Hephaestus-Arm/Hephaestus-Brain/README.md

# Hephaestus-Brain
Samd 51 M4 based robot controller

# Breadboard and OTS variant



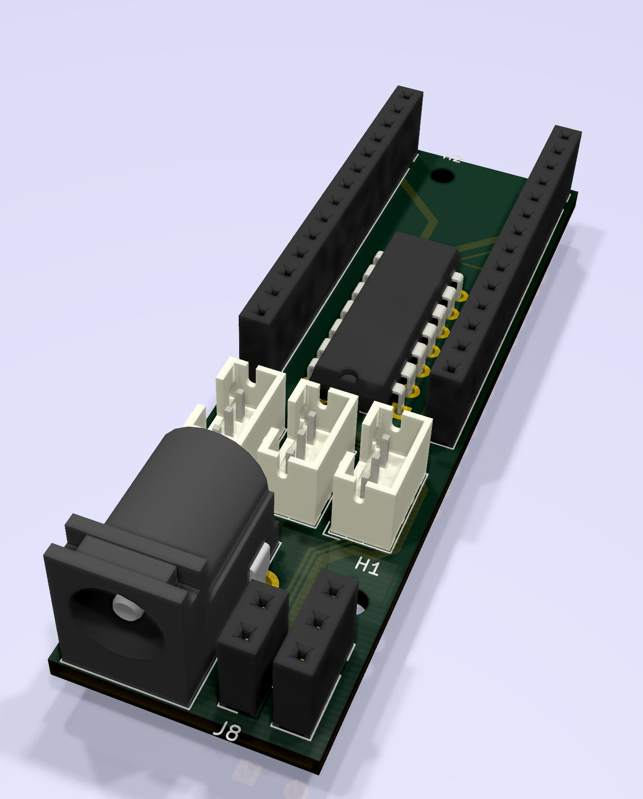
[picture p1: board.png]
Image of PCB
