Hephaestus-Arm/Hephaestus-Brain/pcb.png

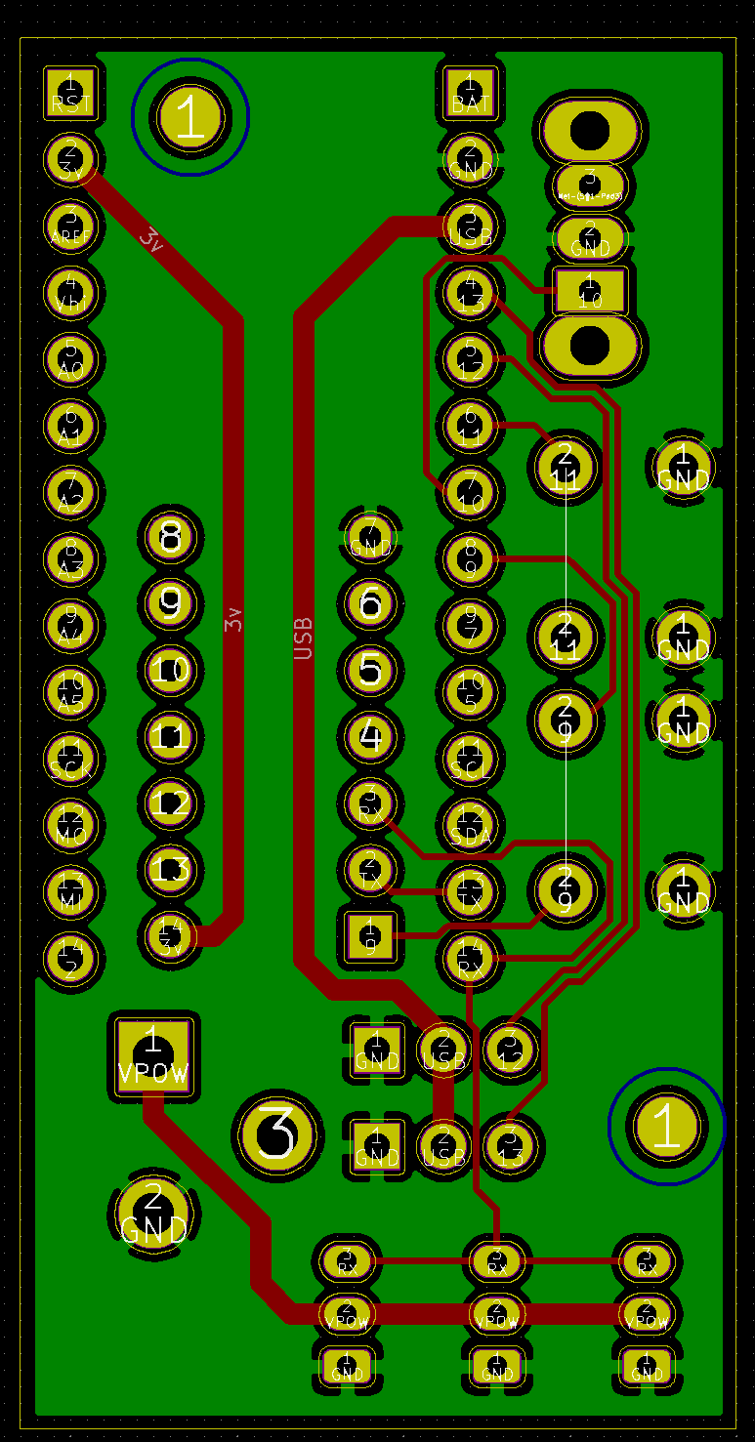
pcb.png
