Hephaestus-Arm/Hephaestus-Brain/schematic.png

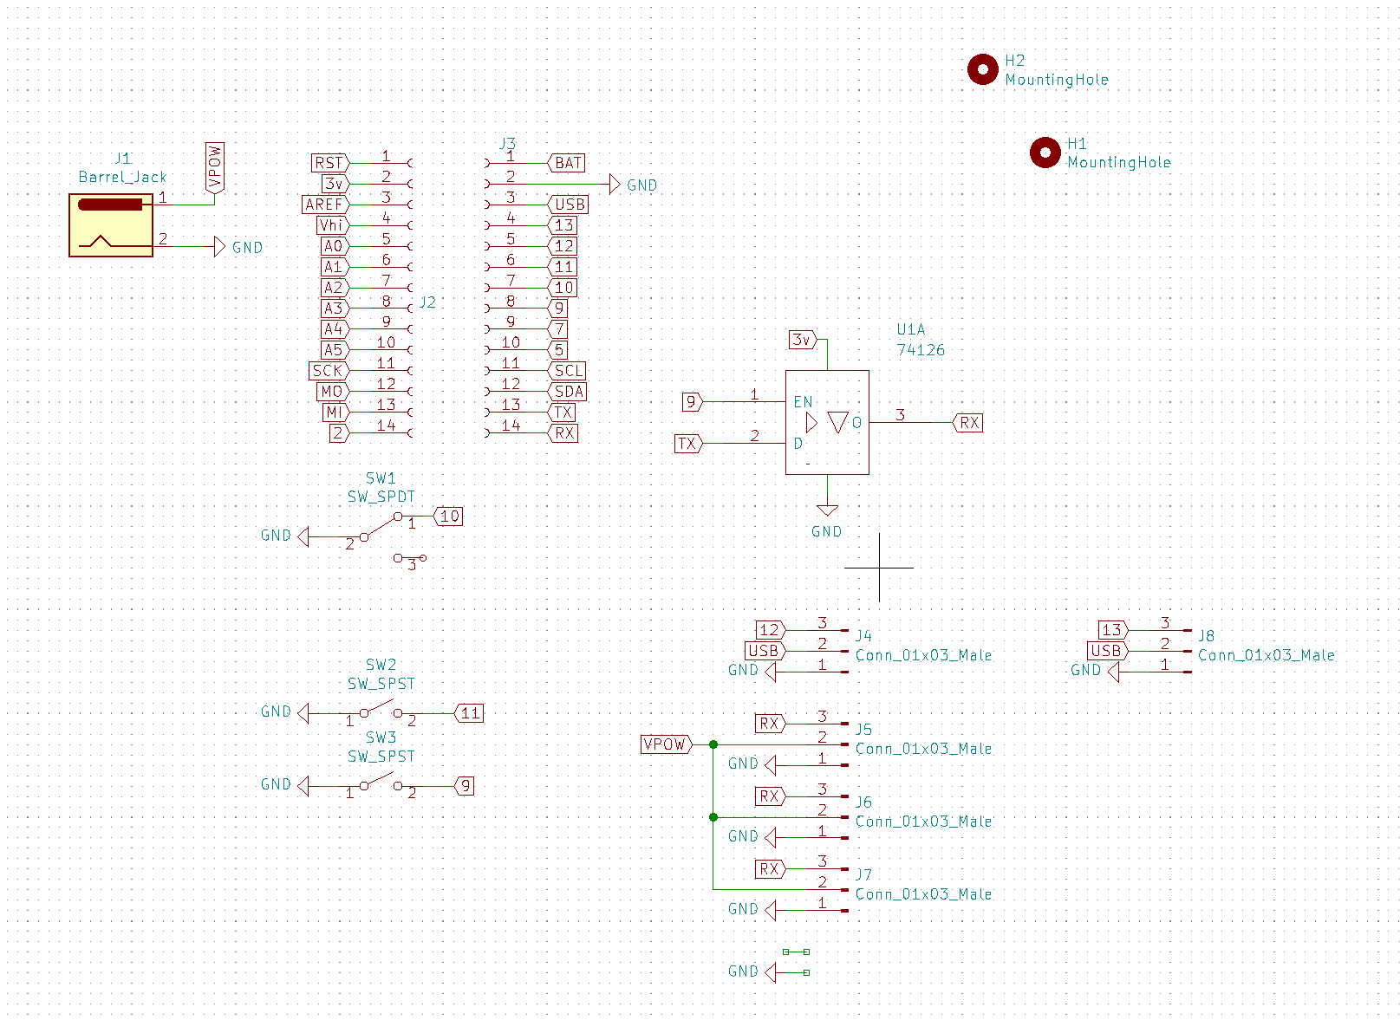
schematic.png
