Hephaestus-Arm/Hephaestus-Brain/hephaestus-brain-pcb-SMT-MIXED.xls

Reference | Quantity | Value | Footprint | MPN | LCSC | DK
C1 C2 | 2 | 22uF 16v | 0805_2012 | GRM219R61C226ME15L | C162295
C3 C5 | 2 | 1uF 16v | 0603_1608 | 0603F105Z160CT | C123519
C4 C6 C7 | 3 | "10uF" | 0603_1608 | CL10A106MO8NQNC | C92487
D2 D1 | 2 | "D" | SOD-323" | PMEG4005EJ,115 | C426868
D3 | 1 | "APA102-2020" | LED-APA102-2020"
IC1 | 1 | "ATSAMD51G19A-MU" | QFN50P700X700X90-49N-D" | ATSAMD51G19A-MU |  | ATSAMD51G19A-MU-ND
J1 | 1 | "Barrel_Jack" | CUI_PJ-102AH_Horizontal" | DC-005-20A | C130239
J2 | 1 | "Conn_02x03_Odd_Even" | 2x03_P2.54mm_Vertical" | 210-72-03GB01 | C402781
J3 | 1 | "StemmaQT" | 1x04-1MP_P1.00mm_Horizontal" | C145956 | C145956
J5 J6 J7 | 3 | "Conn_01x03_Male" | JST_PH_B3B-PH-K_1x03 | B3B-PH-K-S(LF)(SN) | C131339
J8 | 1 | "USB4110-GF-A" | GCT_USB4110-GF-A | TYPE-C-31-M-12 | C165948
R2 R1 | 2 | "100k" | 0603_1608 | 0603WAJ0104T5E | C15458
R3 | 1 | "10k" | 0603_1608 | RC0603FR-0710KL | C98220
R5 R4 | 2 | "5.1k" | 0603_1608 | RCT035K1JLF | C177348
SW1 | 1 | "SW_SPDT" | SK3296S01L1 | SK-3296S-01-L1 | C319020
SW2 SW3 | 2 | "SW_SPST" | TL3305C | TS4560TP | C412374
U1 | 1 | "LM1117-5.0" | SOT-223 | LM1117MP-5.0/TR | C498151
U2 | 1 | "AP2112K-3.3" | SOT-23-5 | AP2112K-3.3TRG1 | C51118
U3 | 1 | "AT25xxx-MA" | DFN-8 | GD25Q16CEIGR |  | 1970-1011-2-ND
U4 | 1 | "74LVC1G125" | SOT-353 | 74LVC1G125GW | C703585
PCB | 0
ASSY | 0
