Hephaestus-Arm/Hephaestus-Brain/Component_Placement.pdf

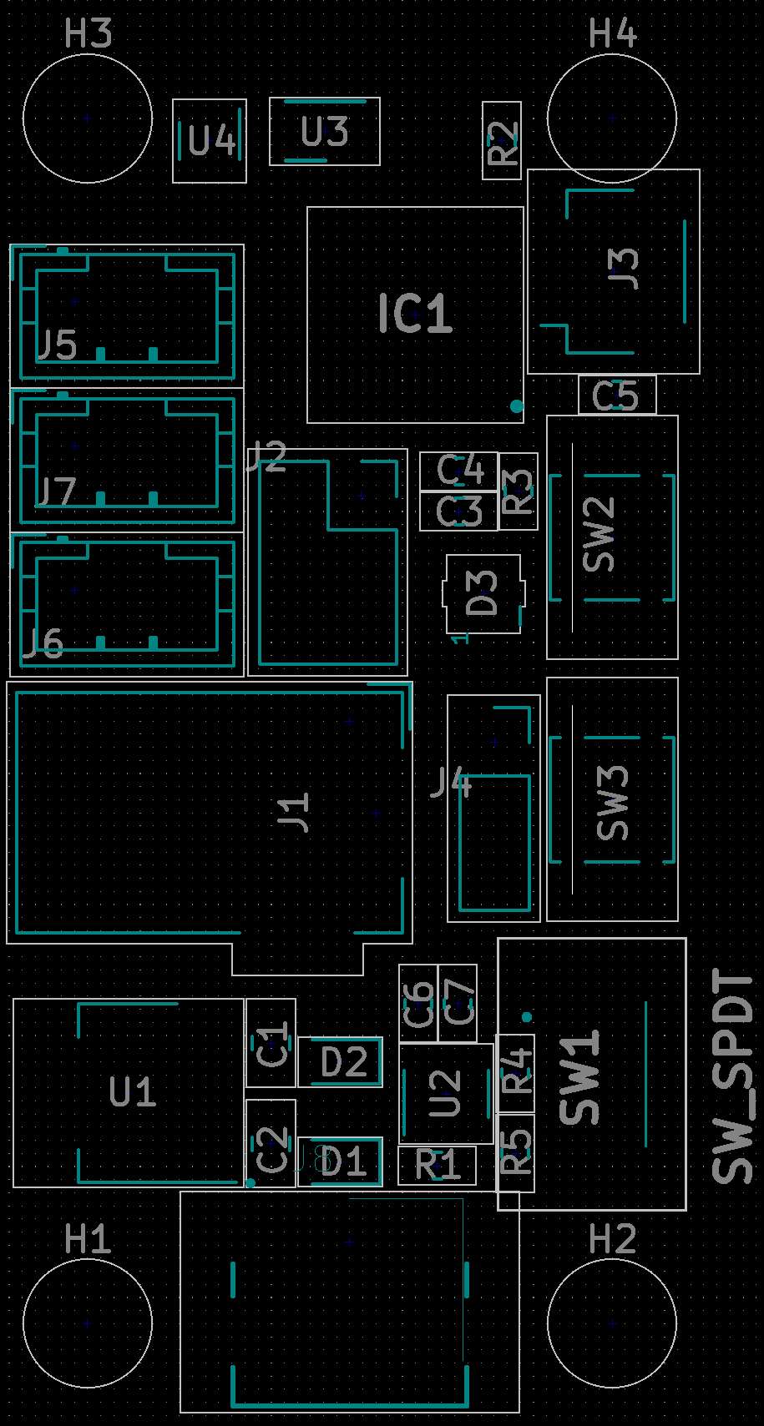
[picture p4: figure]
