Hephaestus-Arm/Hephaestus-Brain/keystone-PN5005.STEP

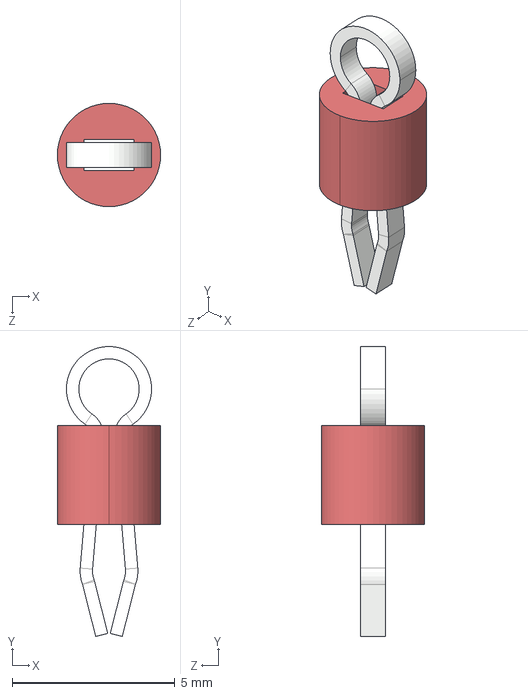
[picture p5: CAD file, 2021-06-16]
keystone-PN5005.STEP
3.18 x 8.92 x 3.18 mm
