Hephaestus-Arm/Hephaestus-Brain/PJ-102AH--3DModel-STEP-56544.STEP

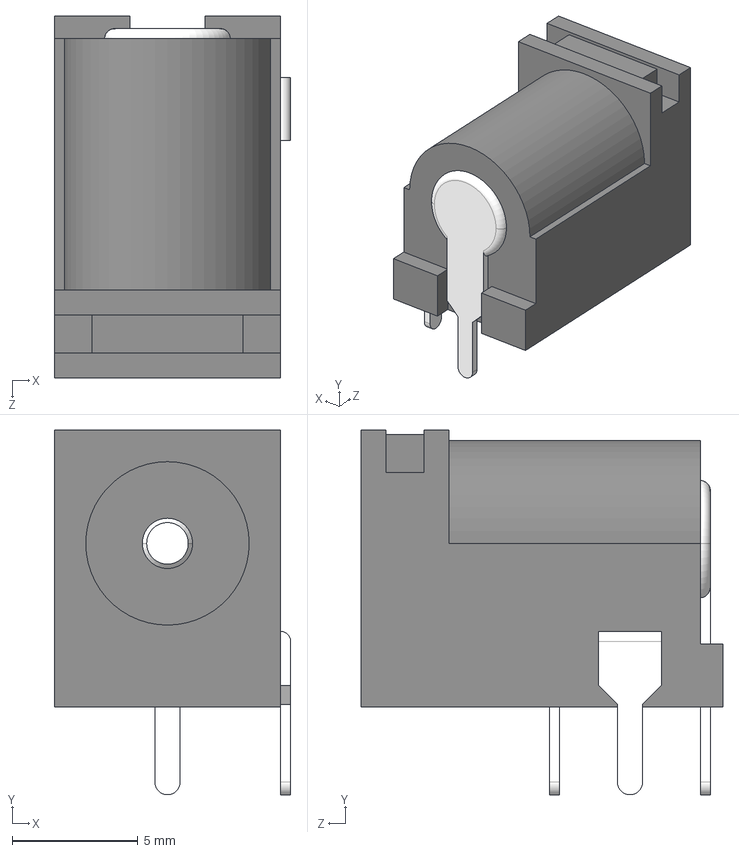
[picture p6: CAD file, 2020-07-22]
PJ-102AH--3DModel-STEP-56544.STEP
9.40 x 14.5 x 14.4 mm
