Hephaestus-Arm/Hephaestus-Brain/OS102011MS2QN1.stp

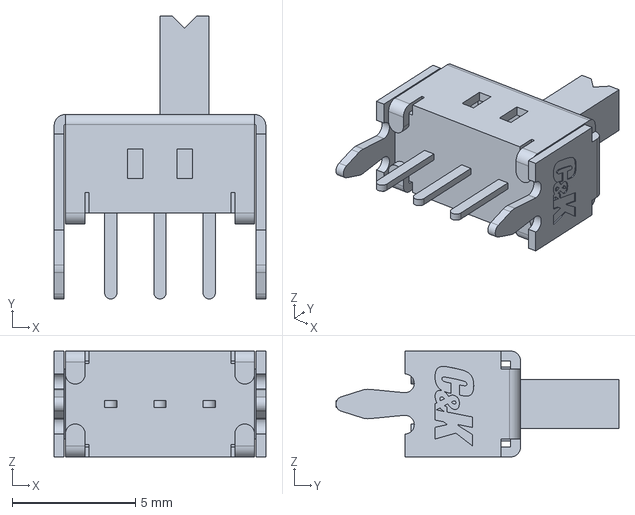
[picture p7: CAD file, 2020-07-23]
OS102011MS2QN1.stp
8.60 x 11.5 x 4.30 mm
