Hephaestus-Arm/Hephaestus-Brain/(threads)

Thread 1 (2020-06-25):

Clone Feather M4 footprint and pinout

madhephaestus, 2020-06-25:
https://www.adafruit.com/product/3857

Clone the footprint of the feather.

Leave off the battery charger/connector
~~Leave off the neopixel~~

All other pins and features should match. LED on pin 13, the reset switch and USB port.

Switching to USB-C is ok

acamilo, 2020-06-25:
i want the neopixel

Closed 2020-12-10.

Thread 11 (2020-06-25):

Small switch on GPIO 10 to sw disable the motors

madhephaestus, 2020-06-25:
If power for the motors is cut, then the position feedback dies too. THis is for the user to set the module into back-drive mode with the calibrated position feedback still running.

Maybe a jumper instead?

madhephaestus, 2020-06-25:
Switch takes GPIO 10 and ties it to GND when closed.

Label for it is "MOTOR Disable/enable"

Closed 2020-12-10.

Thread 12 (2020-06-25):

Make wiring diagram for breadboard version

madhephaestus, 2020-06-25:
Make a set of wiring diagrams for students to make this board using the ItsyBitsy and a breadboard. Follow the example that @acamilo made for the RBE 2001/2 wiring instructions found here:

https://github.com/WPIRoboticsEngineering/RBE2001_template/blob/master/wiring/wiring.md

and the example circuit here:

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

madhephaestus, 2020-07-22:
i saw the first rev of the image, where did that end up, cna this be closed?

madhephaestus, 2020-08-12:
I need this diagram this afternoon, i saw it at some point, where did it go?

Closed 2020-12-10.

Thread 13 (2020-06-25):

Add one servo header

madhephaestus, 2020-06-25:
Signal to GPIO 12
Power to VUSB/5v
Gnd to gnd

Male header

Clearly labeled to avoid reverse connection, non-keyed connector

Closed 2020-12-10.

Thread 14 (2020-06-25):

[Desirement] some sort of current sense on each power line for the 3 LewanSoul connectors

madhephaestus, 2020-06-25:
measuring the current going into each connector would be cool and super useful.

Measurements should be fast < 0.15ms

I don't know how accurate you can make it, you tell me

Lets say no more than $10 in additional cost?

Thread 5 (2020-06-25):

Add 3x lewanSoul headers

madhephaestus, 2020-06-25:
https://images-na.ssl-images-amazon.com/images/I/61xyUHTZIzL._AC_SL1000_.jpg

Thease headers, 3x on the same lines.

Pinout As you look at that header, with the knotch up:

Ground, 7.5v, SlwanSoiulSerial

Closed 2020-12-10.

Thread 16 (2020-08-04):

Add a Wii connection to the i2c lines with pullups

madhephaestus, 2020-08-04:
A jog controller is something that has been asked for, easiest way to add that is to add a Wii connector and pushing the controller data up the same channel as the motor commands, rather then trying to get Matlab on Linux to talk to a joystick.

Thread 18 (2020-12-04):

Mount holes should Be 3.1mm and on a 5mm grid

madhephaestus, 2020-12-04:
The mount holes should be clearance for an M3 bolt, and also lie on a grid of holes of 5mm increments.

Thread 19 (2020-12-04):

Break out the unused GPIO to an unpolulated header

madhephaestus, 2020-12-04:

madhephaestus, 2020-12-12:
I had a thought on this: Could we make the IO header pin compatible to a DevKit-C so it could plug straight into the ZenDriver is headers were soldered?

Thread 20 (2020-12-04):

LED on GPIO 11 is missing

madhephaestus, 2020-12-04:
There should be a simple LED on gpio 11.

Thread 21 (2020-12-05):

Communication to Bus servo not working

madhephaestus, 2020-12-05:
I connected the bus servo and can not get the fw to talk to the bus servo.

What test was done to test if the hephaestus firmware was working?

Load the fw from here:

https://github.com/Hephaestus-Arm/HephaestusArm2-firmware/releases/download/0.0.4/CURRENT.UF2

The servo must be powered.

Open the serial port and type

```
ID
```
and hit enter. It should print a non zero ID. If the ID is zero, it is not communicating.

to set an ID

```
ID 2
```

will set the ID of the serfo to 2.

To run the arm you need ID 1,2,3 for the links respectively.
