Hephaestus-Arm/Hephaestus-Brain/hephaestus-brain-pcb-kit-pth-v2.kicad_pcb

## KiCad design hephaestus-brain-pcb-kit-pth-v2.kicad_pcb (2021-07-16)

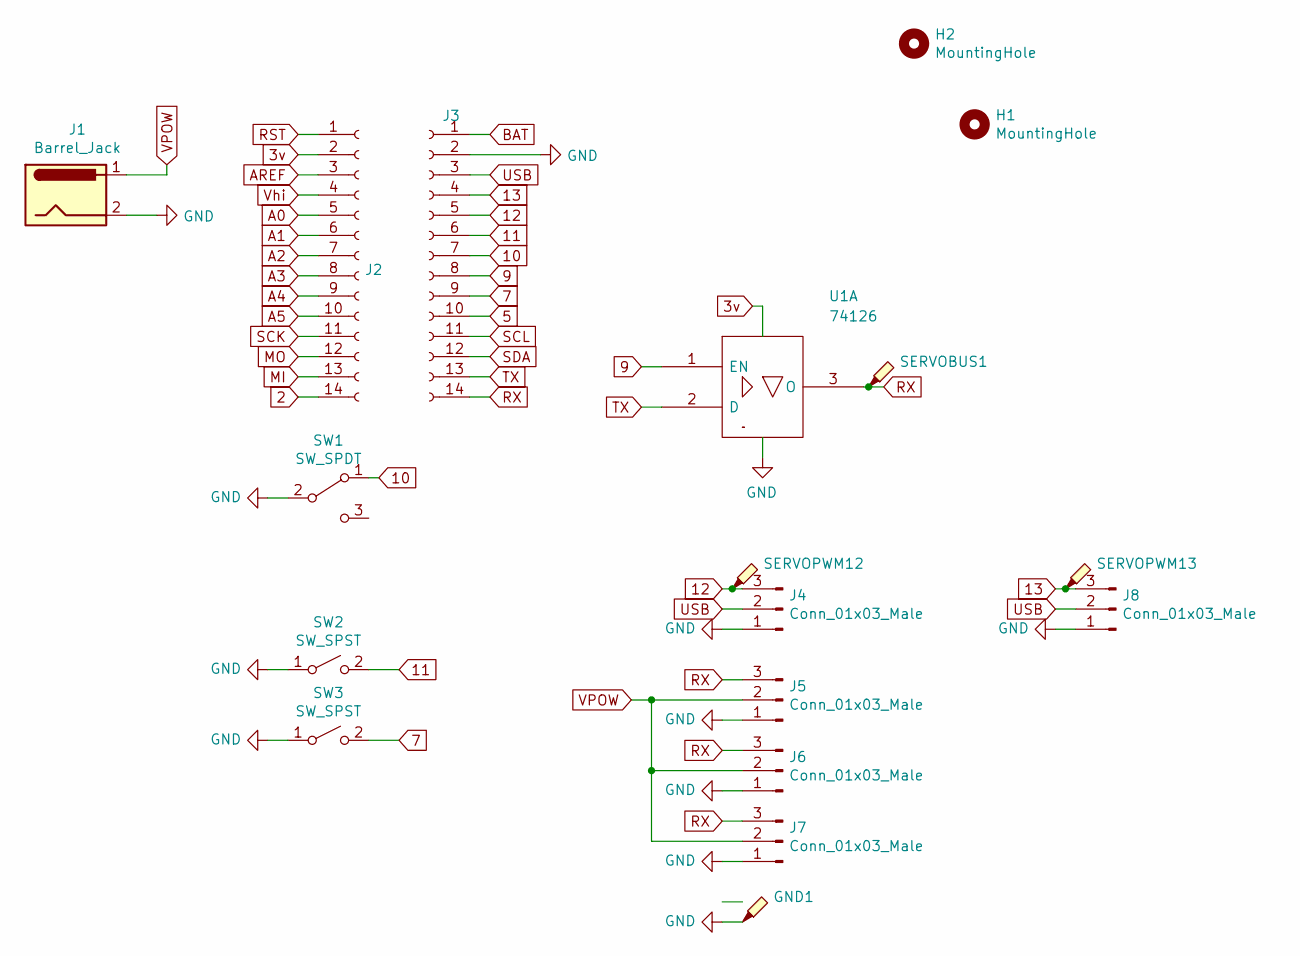
[picture p8: schematic hephaestus-brain-pcb-kit-pth-v2.sch]

Parts:
GND1: TestPoint_Probe; TestPoint_Keystone_5005-5009_Compact
H1, H2: MountingHole; MountingHole_2.2mm_M2
J1: Barrel_Jack; BarrelJack_CUI_PJ-102AH_Horizontal
J2, J3: ItsyBitsy; PinSocket_1x14_P2.54mm_Vertical
J4, J8: Conn_01x03_Male; PinSocket_1x03_P2.54mm_Vertical
J5, J6, J7: Conn_01x03_Male; JST_PH_B3B-PH-K_1x03_P2.00mm_Vertical
SERVOBUS1: TestPoint_Probe; TestPoint_Keystone_5005-5009_Compact
SERVOPWM12, SERVOPWM13: TestPoint_Probe; TestPoint_Keystone_5005-5009_Compact
SW1: SW_SPDT; SW_Slide_1P2T_CK_OS102011MS2Q
SW2, SW3: SW_SPST; SW_PUSH_6mm
U1: 74126; DIP-14_W7.62mm

Connections:
2: J2.14
3v: J2.2, U1.14 (VCC)
5: J3.10
7: J3.9, SW3.2 (B)
9: J3.8, U1.1 (EN)
10: J3.7, SW1.1 (A)
11: J3.6, SW2.2 (B)
12: J3.5, J4.3, SERVOPWM12.1
13: J3.4, J8.3, SERVOPWM13.1
A0: J2.5
A1: J2.6
A2: J2.7
A3: J2.8
A4: J2.9
A5: J2.10
AREF: J2.3
BAT: J3.1
GND: GND1.1, J1.2, J3.2, J4.1, J5.1, J6.1, J7.1, J8.1, SW1.2 (B), SW2.1 (A), SW3.1 (A), U1.7 (GND)
MI: J2.13
MO: J2.12
RST: J2.1
RX: J3.14, J5.3, J6.3, J7.3, SERVOBUS1.1, U1.3 (O)
SCK: J2.11
SCL: J3.11
SDA: J3.12
TX: J3.13, U1.2 (D)
USB: J3.3, J4.2, J8.2
VPOW: J1.1, J5.2, J6.2, J7.2
Vhi: J2.4

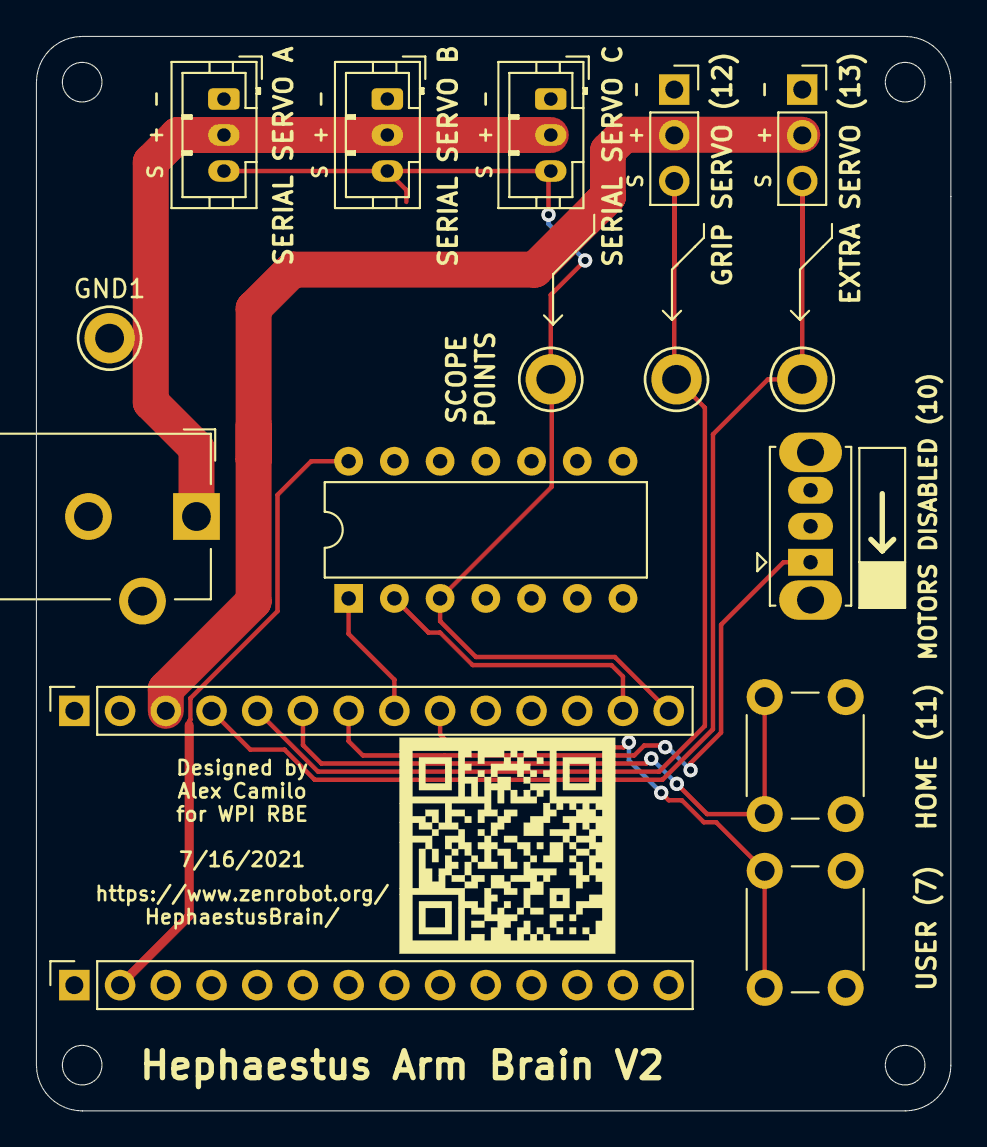
[picture p9: board hephaestus-brain-pcb-kit-pth-v2.kicad_pcb from above]

Board: 2 copper layers, 50.8 x 59.7 mm, 21 parts (0 on the bottom side), 12 nets.

Other parts of the board:
H1#2, H1#3: MountingHole; MountingHole_2.2mm_M2
Ref**: Val**; QRCode
