Hephaestus-Arm/Hephaestus-Brain/hephaestus-brain-pcb-SMT-MIXED-REV2.kicad_pcb

## KiCad design hephaestus-brain-pcb-SMT-MIXED-REV2.kicad_pcb (2021-06-16)

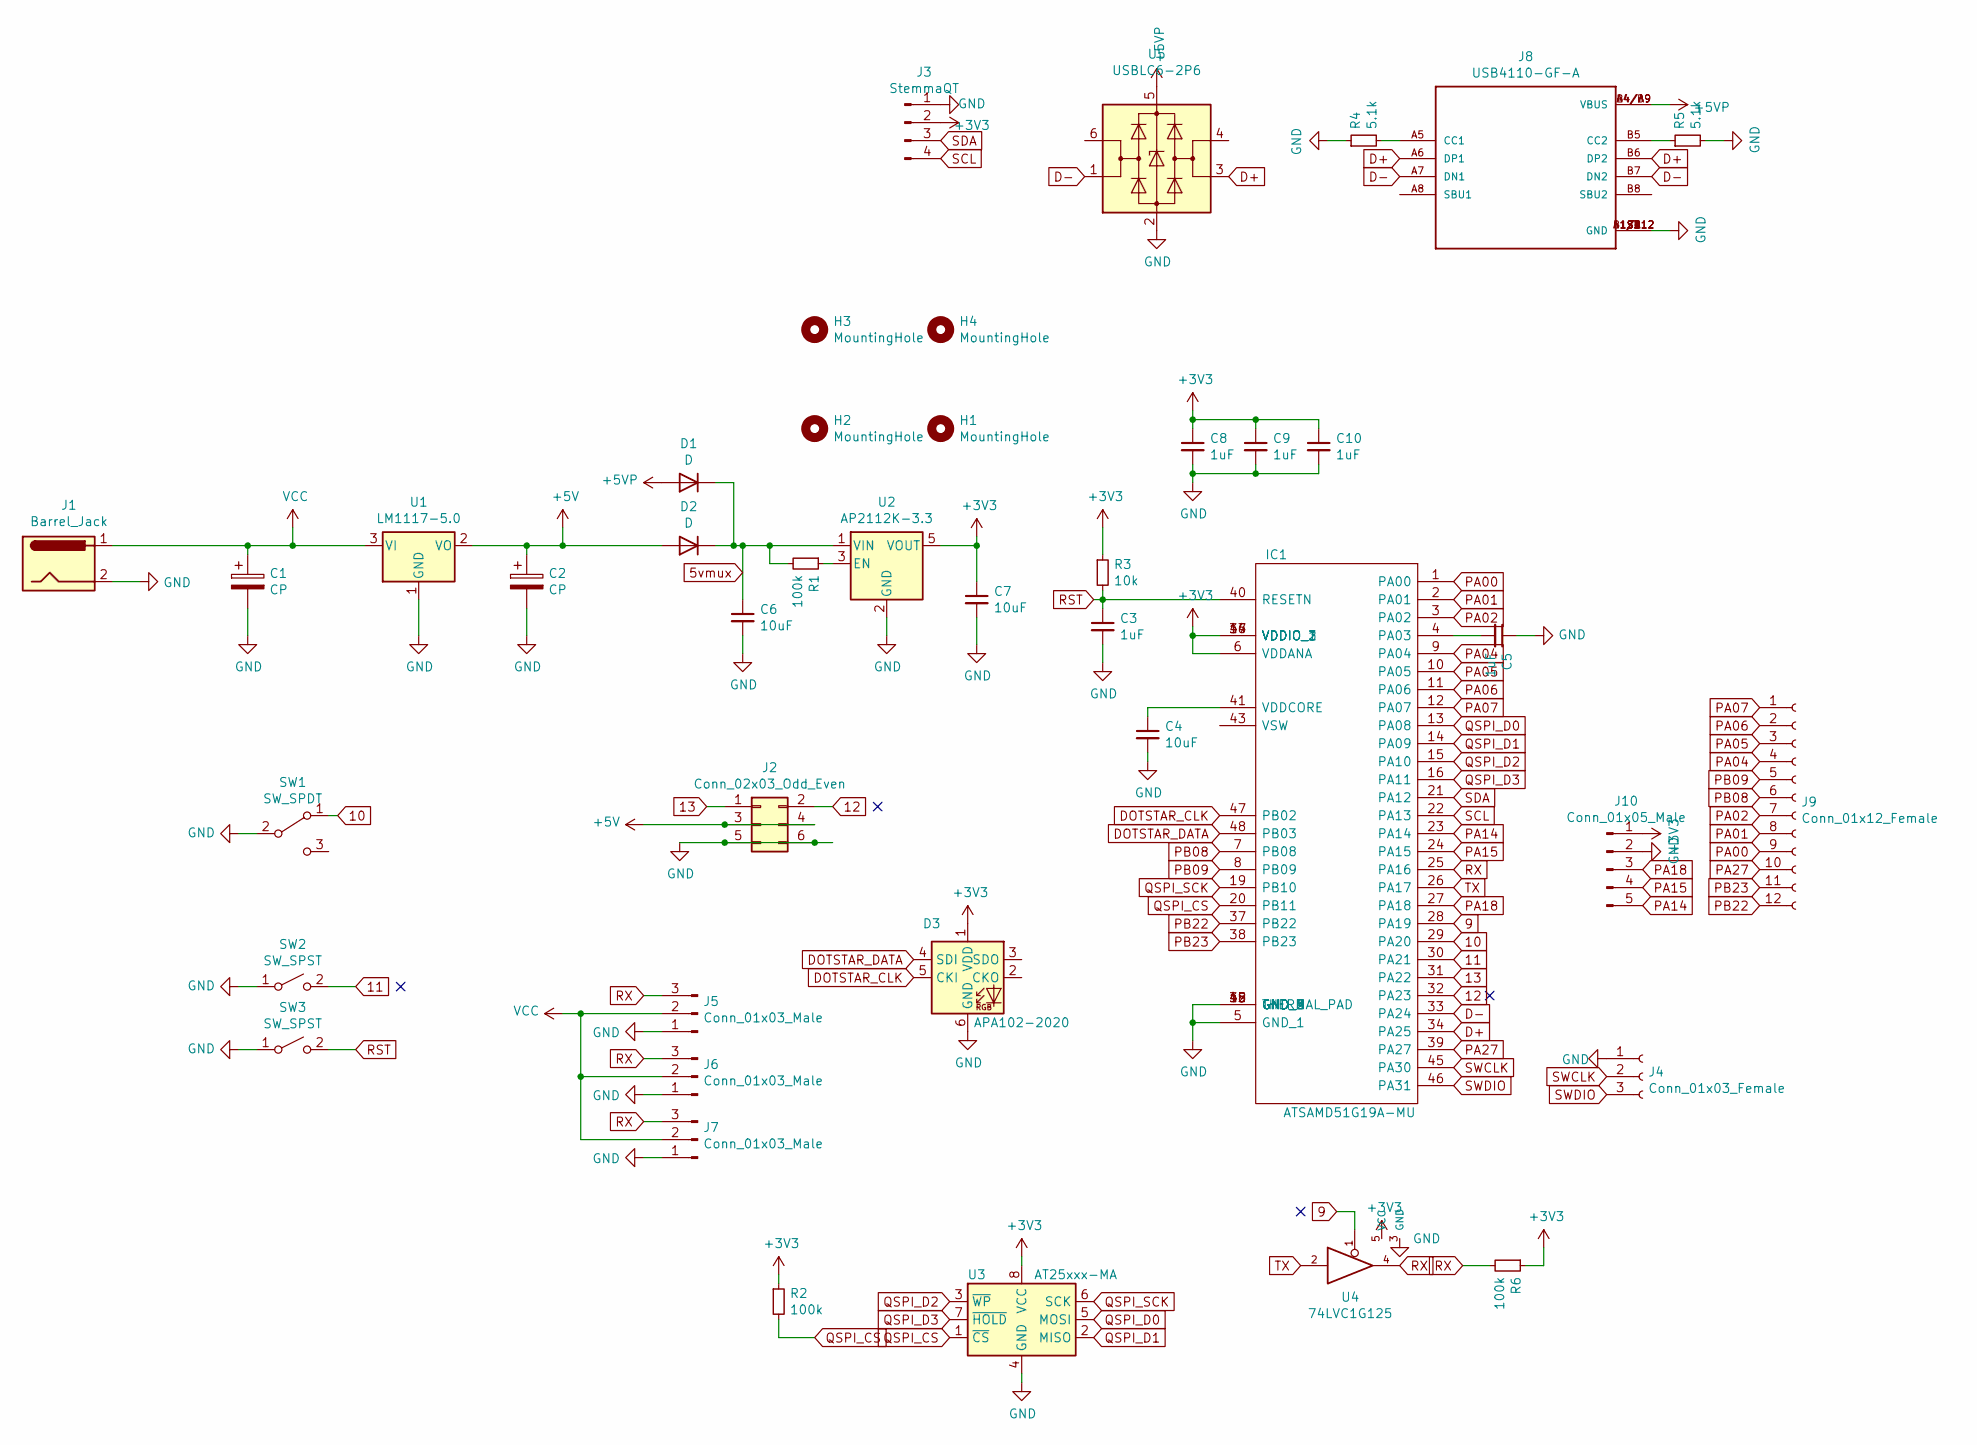
[picture p10: schematic hephaestus-brain-pcb-SMT-MIXED-REV2.sch]

Parts:
C1, C2: CP; C_0805_2012Metric
C3, C5, C8, C9, C10: 1uF; R_0603_1608Metric
C4, C6, C7: 10uF; R_0603_1608Metric
D1, D2: D; D_SOD-323
D3: APA102-2020; LED-APA102-2020
H1, H2, H3, H4: MountingHole; MountingHole_2.2mm_M2
IC1: ATSAMD51G19A-MU; QFN50P700X700X90-49N-D; Manufacturer_Part_Number ATSAMD51G19A-MU; Mouser Part Number 556-ATSAMD51G19AMU
J1: Barrel_Jack; BarrelJack_Wuerth_6941xx301002; mpn DC-005-5A-2.0-SMT; lcsc C319134
J2: Conn_02x03_Odd_Even; PinSocket_2x03_P2.54mm_Vertical
J3: StemmaQT; JST_SH_SM04B-SRSS-TB_1x04-1MP_P1.00mm_Horizontal
J4: Conn_01x03_Female; PinSocket_1x03_P2.54mm_Vertical
J5, J6, J7: Conn_01x03_Male; JST_PH_B3B-PH-K_1x03_P2.00mm_Vertical
J8: USB4110-GF-A; GCT_USB4110-GF-A
J9: Conn_01x12_Female; PinSocket_1x12_P2.54mm_Vertical
J10: Conn_01x05_Male; PinSocket_1x05_P2.54mm_Vertical
R1, R2, R6: 100k; R_0603_1608Metric
R3: 10k; R_0603_1608Metric
R4, R5: 5.1k; R_0603_1608Metric
SW1: SW_SPDT; SS12D06L5
SW2, SW3: SW_SPST; SW_SPST_TL3305C
U1: LM1117-5.0; SOT-223
U2: AP2112K-3.3; SOT-23-5; mpn AP2112K-3.3TRG1; lcsc C51118
U3: AT25xxx-MA; DFN-8-1EP_3x2mm_P0.5mm_EP1.75x1.45mm
U4: 74LVC1G125; SOT-353_SC-70-5
U5: USBLC6-2P6; SOT-666

Connections:
5vmux: C6.1, D1.1 (K), D2.1 (K), R1.2, U2.1 (VIN)
9: IC1.28 (PA19), U4.1
10: IC1.29 (PA20), SW1.1 (A)
11: IC1.30 (PA21), SW2.2 (B)
12: IC1.32 (PA23), J2.2
13: IC1.31 (PA22), J2.1
+3V3: C7.1, C8.1, C9.1, C10.1, D3.1 (VDD), IC1.6 (VDDANA), IC1.17 (VDDIO_1), IC1.36 (VDDIO_2), IC1.44 (VDDIO_3), J3.2, J10.1, R2.1, R3.1, R6.1, U2.5 (VOUT), U3.8 (VCC), U4.5 (VCC)
+5V: C2.1, D2.2 (A), J2.3, J2.4, U1.2 (VO)
+5VP: D1.2 (A), J8.A4/B9 (VBUS), J8.B4/A9 (VBUS), U5.5 (VBUS)
D+: IC1.34 (PA25), J8.A6 (DP1), J8.B6 (DP2), U5.3 (I/O2)
D-: IC1.33 (PA24), J8.A7 (DN1), J8.B7 (DN2), U5.1 (I/O1)
DOTSTAR_CLK: D3.5 (CKI), IC1.47 (PB02)
DOTSTAR_DATA: D3.4 (SDI), IC1.48 (PB03)
GND: C1.2, C2.2, C3.2, C4.2, C5.1, C6.2, C7.2, C8.2, C9.2, C10.2, D3.6 (GND), IC1.5 (GND_1), IC1.18 (GND_2), IC1.35 (GND_3), IC1.42 (GND_4), IC1.49 (THERMAL_PAD), J1.2, J2.5, J2.6, J3.1, J4.1, J5.1, J6.1, J7.1, J8.A1/B12 (GND), J8.B1/A12 (GND), J8.S1 (GND), J8.S2 (GND), J8.S3 (GND), J8.S4 (GND), J10.2, R4.1, R5.2, SW1.2 (B), SW2.1 (A), SW3.1 (A), U1.1 (GND), U2.2 (GND), U3.4 (GND), U3.9 (GND), U4.3 (GND), U5.2 (GND)
unnamed: C4.1, IC1.41 (VDDCORE)
unnamed: C5.2, IC1.4 (PA03)
unnamed: J8.A5 (CC1), R4.2
unnamed: J8.B5 (CC2), R5.1
unnamed: R1.1, U2.3 (EN)
PA00: IC1.1 (PA00), J9.9
PA01: IC1.2 (PA01), J9.8
PA02: IC1.3 (PA02), J9.7
PA04: IC1.9 (PA04), J9.4
PA05: IC1.10 (PA05), J9.3
PA06: IC1.11 (PA06), J9.2
PA07: IC1.12 (PA07), J9.1
PA14: IC1.23 (PA14), J10.5
PA15: IC1.24 (PA15), J10.4
PA18: IC1.27 (PA18), J10.3
PA27: IC1.39 (PA27), J9.10
PB08: IC1.7 (PB08), J9.6
PB09: IC1.8 (PB09), J9.5
PB22: IC1.37 (PB22), J9.12
PB23: IC1.38 (PB23), J9.11
QSPI_CS: IC1.20 (PB11), R2.2, U3.1 (~CS)
QSPI_D0: IC1.13 (PA08), U3.5 (MOSI)
QSPI_D1: IC1.14 (PA09), U3.2 (MISO)
QSPI_D2: IC1.15 (PA10), U3.3 (~WP)
QSPI_D3: IC1.16 (PA11), U3.7 (~HOLD)
QSPI_SCK: IC1.19 (PB10), U3.6 (SCK)
RST: C3.1, IC1.40 (RESETN), R3.2, SW3.2 (B)
RX: IC1.25 (PA16), J5.3, J6.3, J7.3, R6.2, U4.4
SCL: IC1.22 (PA13), J3.4
SDA: IC1.21 (PA12), J3.3
SWCLK: IC1.45 (PA30), J4.2
SWDIO: IC1.46 (PA31), J4.3
TX: IC1.26 (PA17), U4.2
VCC: C1.1, J1.1, J5.2, J6.2, J7.2, U1.3 (VI)

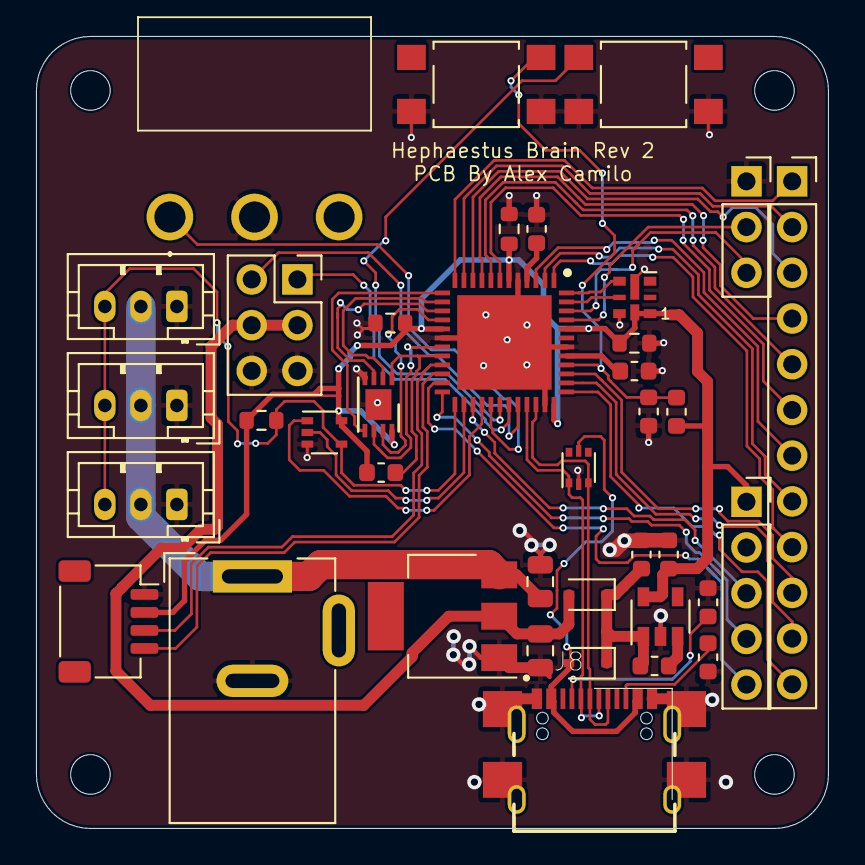
[picture p11: board hephaestus-brain-pcb-SMT-MIXED-REV2.kicad_pcb from above]

Board: 2 copper layers, 44.0 x 44.0 mm, 42 parts (0 on the bottom side), 48 nets.
