Hephaestus-Arm/Hephaestus-Brain/hephaestus-brain-pcb-SMT-MIXED-Jig.kicad_pcb

## KiCad design hephaestus-brain-pcb-SMT-MIXED-Jig.kicad_pcb (2020-11-20)

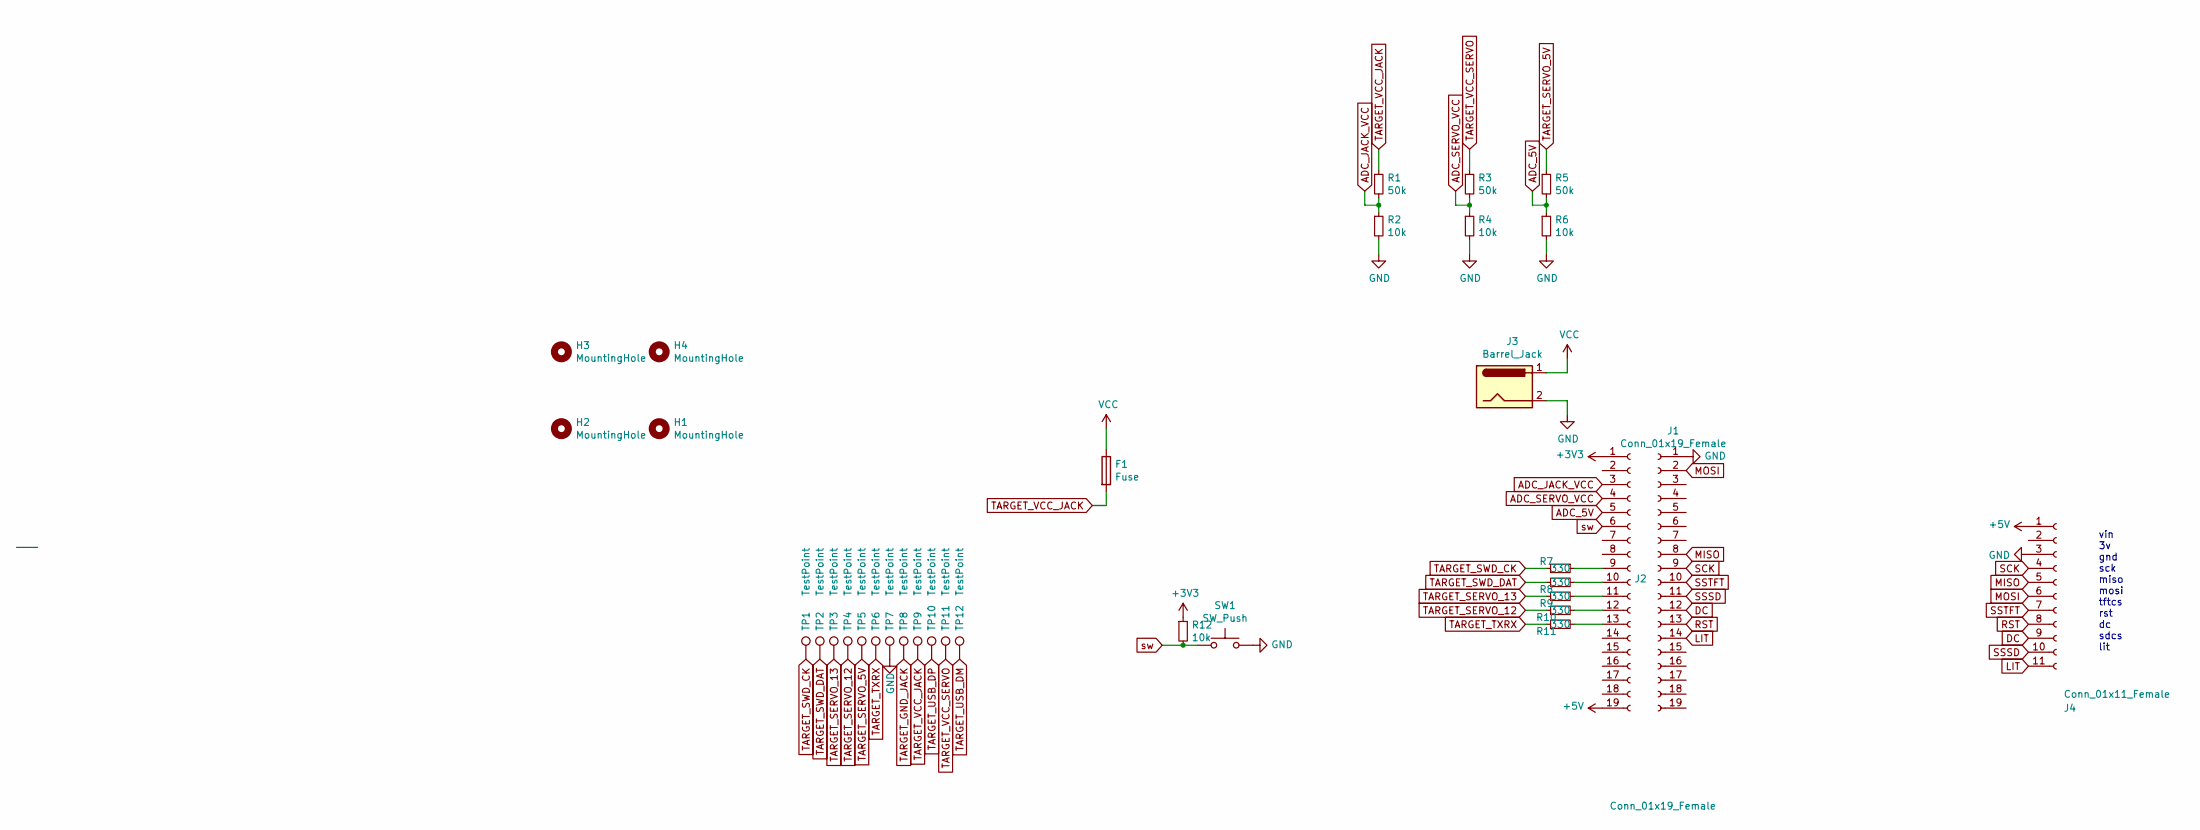
[picture p12: schematic hephaestus-brain-pcb-SMT-MIXED-jig.sch]

Parts:
F1: Fuse; NANO-0154-OMNI-BLOK-Fuse-Holder
H1, H2, H3, H4: MountingHole; MountingHole_2.2mm_M2
J1, J2: Conn_01x19_Female; PinSocket_1x19_P2.54mm_Vertical
J3: Barrel_Jack; BarrelJack_Wuerth_6941xx301002
J4: Conn_01x11_Female; PinSocket_1x11_P2.54mm_Vertical
R1, R3, R5: 50k; R_0603_1608Metric
R2, R4, R6, R12: 10k; R_0603_1608Metric
R7, R8, R9, R10, R11: 330; R_0603_1608Metric
SW1: SW_Push; SW_PUSH_6mm
TP1, TP2, TP3, TP4, TP5, TP6, TP7, TP8, TP9, TP10, TP11, TP12: TestPoint; TestPoint_Pad_D1.5mm

Connections:
+3V3: J2.1, R12.1
+5V: J2.19, J4.1
ADC_5V: J2.5, R5.2, R6.1
ADC_JACK_VCC: J2.3, R1.2, R2.1
ADC_SERVO_VCC: J2.4, R3.2, R4.1
DC: J1.12, J4.9
GND: J1.1, J3.2, J4.3, R2.2, R4.2, R6.2, SW1.2, TP7.1
LIT: J1.14, J4.11
MISO: J1.8, J4.5
MOSI: J1.2, J4.6
unnamed: J2.9, R7.1
unnamed: J2.10, R8.2
unnamed: J2.11, R9.2
unnamed: J2.12, R10.2
unnamed: J2.13, R11.2
RST: J1.13, J4.8
SCK: J1.9, J4.4
SSSD: J1.11, J4.10
SSTFT: J1.10, J4.7
TARGET_GND_JACK: TP8.1
TARGET_SERVO_5V: R5.1, TP5.1
TARGET_SERVO_12: R10.1, TP4.1
TARGET_SERVO_13: R9.1, TP3.1
TARGET_SWD_CK: R7.2, TP1.1
TARGET_SWD_DAT: R8.1, TP2.1
TARGET_TXRX: R11.1, TP6.1
TARGET_USB_DM: TP12.1
TARGET_USB_DP: TP10.1
TARGET_VCC_JACK: F1.2, R1.1, TP9.1
TARGET_VCC_SERVO: R3.1, TP11.1
VCC: F1.1, J3.1
sw: J2.6, R12.2, SW1.1

Notes on the sheet:
vin 3v gnd sck miso mosi tftcs rst dc sdcs lit

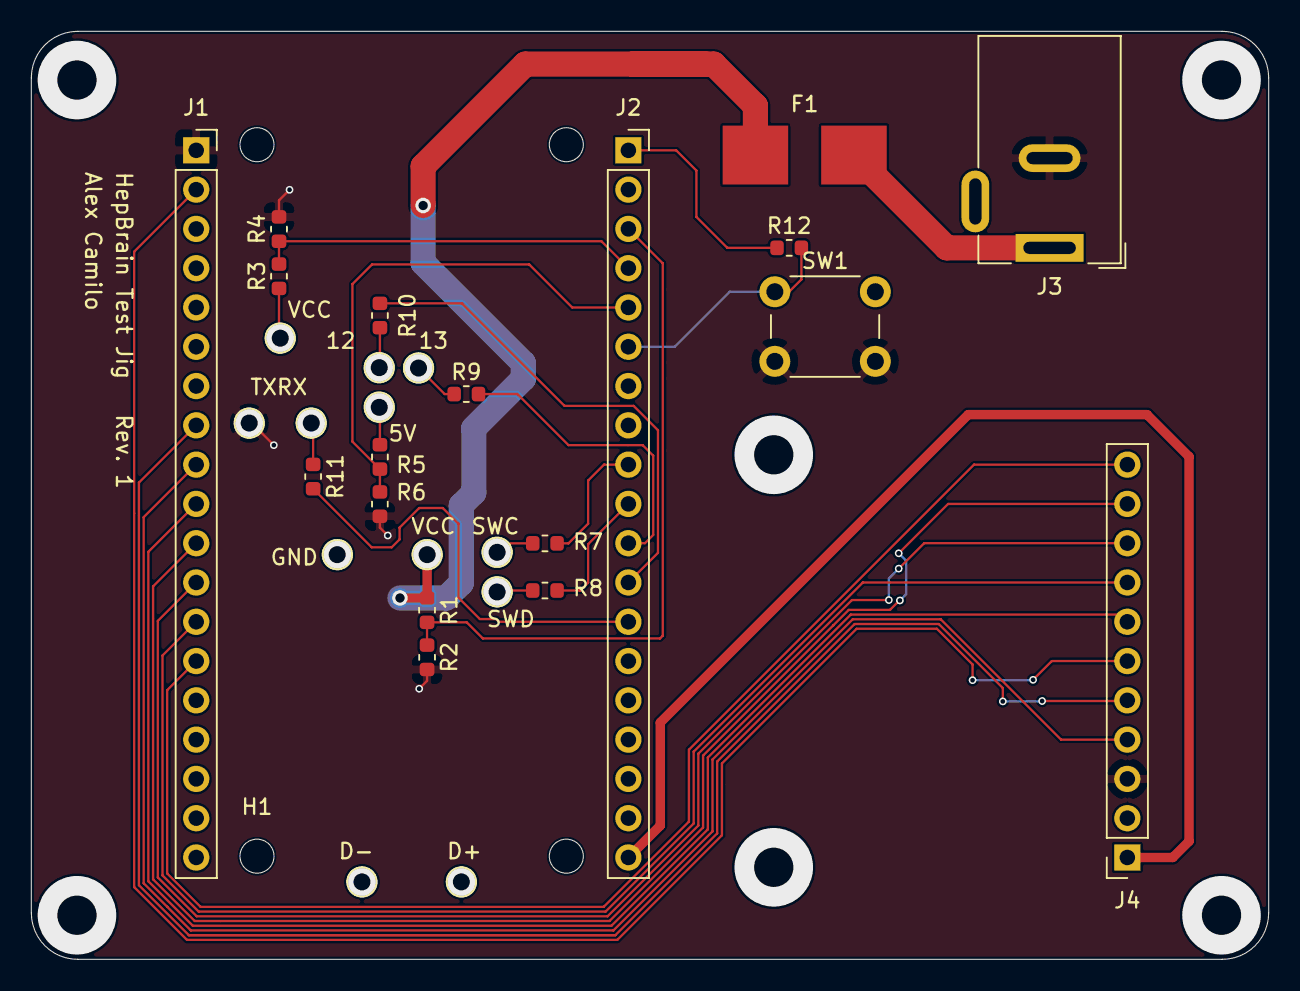
[picture p13: board hephaestus-brain-pcb-SMT-MIXED-Jig.kicad_pcb from above]

Board: 2 copper layers, 80.0 x 60.0 mm, 34 parts (0 on the bottom side), 29 nets.
