Hephaestus-Arm/Hephaestus-Brain/(commit log)

2020-07-22 Rev 1 of board done.
    [PJ-102AH--3DModel-STEP-56544.STEP, hephaestus-brain-pcb.kicad_pcb, hephaestus-brain-pcb.sch]
2020-07-22 Added homing switch connector
    [hephaestus-brain-pcb.kicad_pcb, hephaestus-brain-pcb.sch]
2020-07-23 Added switch, button.
    [OS102011MS2QN1.stp, hephaestus-brain-pcb.kicad_pcb, hephaestus-brain-pcb.sch]
2020-07-23 Updated Silkscreen
    [hephaestus-brain-pcb.kicad_pcb]
2020-08-12 Add board render and wiring diagram
2020-08-12 layer vis, minor visual edits.
    [hephaestus-brain-pcb.kicad_pcb]
2020-10-29 Added bom. FP fix.
    [hephaestus-brain-pcb.csv, hephaestus-brain-pcb.kicad_pcb]
2020-10-29 updated bom to add missing PN
    [hephaestus-brain-pcb.csv]
2020-10-29 uncomitted pcb edits
    [hephaestus-brain-pcb.kicad_pcb]
2020-11-09 SMT Version of brain
    [hephaestus-brain-pcb-SMT.sch, hephaestus-brain-pcb_SMT.kicad_pcb]
2020-11-09 layout done
    [hephaestus-brain-pcb-SMT.kicad_pcb]
2020-11-11 Revision 1 of SMT version
    [hephaestus-brain-pcb-SMT.kicad_pcb, hephaestus-brain-pcb-SMT.sch]
2020-11-12 Mixed SMT-PTH version.
    [hephaestus-brain-pcb-SMT-MIXED.kicad_pcb, hephaestus-brain-pcb-SMT-MIXED.sch, hephaestus-brain-pcb-SMT.kicad_pcb]
2020-11-12 routing tweaks
    [hephaestus-brain-pcb-SMT-MIXED.kicad_pcb]
2020-11-13 Switched over to USBC connector.
    [hephaestus-brain-pcb-SMT-MIXED.kicad_pcb, hephaestus-brain-pcb-SMT-MIXED.sch]
2020-11-13 Added SWD Connector and QWIIC
    [hephaestus-brain-pcb-SMT-MIXED.kicad_pcb, hephaestus-brain-pcb-SMT-MIXED.sch]
2020-11-13 Added more robust USBC Connector
    [hephaestus-brain-pcb-SMT-MIXED.csv, hephaestus-brain-pcb-SMT-MIXED.kicad_pcb]
2020-11-13 Swapped out barrel jack footprint.
    [hephaestus-brain-pcb-SMT-MIXED.kicad_pcb]
2020-11-13 Fixed soldermask issue.
    [hephaestus-brain-pcb-SMT-MIXED.kicad_pcb]
2020-11-13 Added BOM
    [hephaestus-brain-pcb-SMT-MIXED.xls]
2020-11-13 Added board Artwork
    [hephaestus-brain-pcb-SMT-MIXED.kicad_pcb]
2020-11-13 Switched one of the extra buttons to RESET
    [hephaestus-brain-pcb-SMT-MIXED.kicad_pcb]
2020-11-14 Changed with of soldermask between pads to meet MFG spec.
    Changed from 0.2mm to 0.23mm. spec is 0.22mm for red soldermask.
    [hephaestus-brain-pcb-SMT-MIXED.kicad_pcb]
2020-11-17 Updated footprints.
    0.22mm soldermask clearence on the USB and flash ICs
    [hephaestus-brain-pcb-SMT-MIXED.kicad_pcb, hephaestus-brain-pcb-SMT-MIXED.sch]
2020-11-19 Testing Jig
    [hephaestus-brain-pcb-SMT-MIXED-Jig.kicad_pcb, hephaestus-brain-pcb-SMT-MIXED-jig.sch]
2020-11-20 finished jig pcb
    [hephaestus-brain-pcb-SMT-MIXED-Jig.kicad_pcb, hephaestus-brain-pcb-SMT-MIXED-jig.sch]
2020-11-20 updated footprints
    [hephaestus-brain-pcb-SMT.sch]
2021-03-18 Revision 2
    [hephaestus-brain-pcb-SMT-MIXED-REV2.kicad_pcb, hephaestus-brain-pcb-SMT-MIXED-REV2.sch, hephaestus-brain-pcb-SMT-MIXED.kicad_pcb]
2021-06-16 Rev2 of the kit version of the board
    * Spaced everything out, updated silkscreen.
    * moved usb and power to the same edge of the board
    * Switched button IO from 9 to 7
    [hephaestus-brain-pcb-SMT-MIXED-REV2.kicad_pcb, hephaestus-brain-pcb-kit-pth-v2.kicad_pcb, hephaestus-brain-pcb-kit-pth-v2.sch, hephaestus-brain-pcb.kicad_pcb, keystone-PN5005.STEP]
2021-07-16 Updated silkscreen
    * added QR code
    * added board name, rev, author.
    [hephaestus-brain-pcb-kit-pth-v2.kicad_pcb]
